az763/MD_STM32F401RCT6/README.md

# Metal detector "YASHKA & MASHKA" on MCU STM32F401RCT6
Metal detector IB on MCU ARM Cortex-M4 STM32F401RCT6. FM Transmitter KT0803L. Default frequency 108.00 MHz (channel 2160). EEPROM AT24C16N. 
Search coil from "Terminator" metal detector. LC circuit "TX" with parallel resonance. Frequency "TX" 19300 Hz (min. 6000 Hz - max. 31000 Hz). LCD display HD44780. 
The electromagnetic imbalance of the IB sensor should be 10-15 millivolts (maximum 20-30 mV when adjusting the input amplifier). 
This is an experimental level project. 

DD8 search coil. Frequency 19 kHz.
The "TX" winding is 38 turns (19+19) and the "RX" winding is 38 turns. Circuit capacitors "TX" and "RX" with a capacity of 100 nf. The diameter of the mandrel is 170 mm and the diameter of the winding wire is 0.4 mm.
The diameter of the search sensor in the form of DD8 is 200 mm.
