az763/MD_STM32F401RCT6/Doc_md/Black Pill STM32F401RCT6.jpg

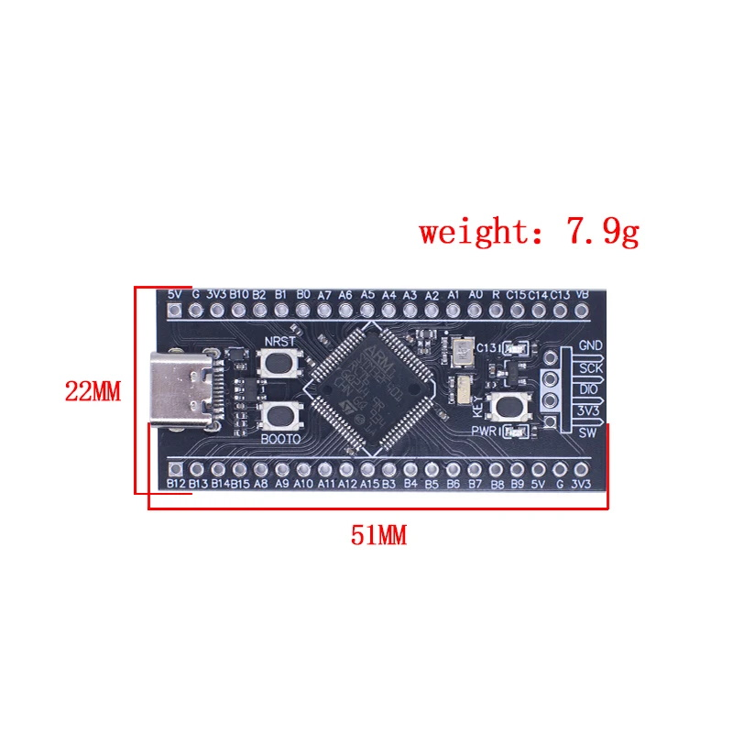
Doc_md/Black Pill STM32F401RCT6.jpg
