az763/MD_STM32F401RCT6/Doc_md/STM32F401 LQFP64 PinOut.jpg

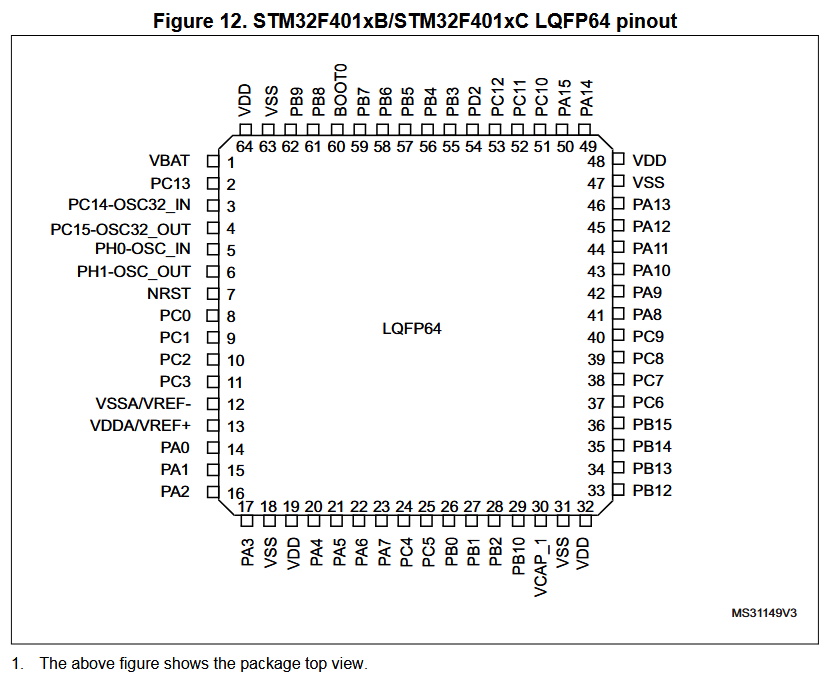
Doc_md/STM32F401 LQFP64 PinOut.jpg
