az763/MD_STM32F401RCT6/PCB/PCB_MD_STM32F401RCT6_1.5_mod_05_OK_foto_00.JPG

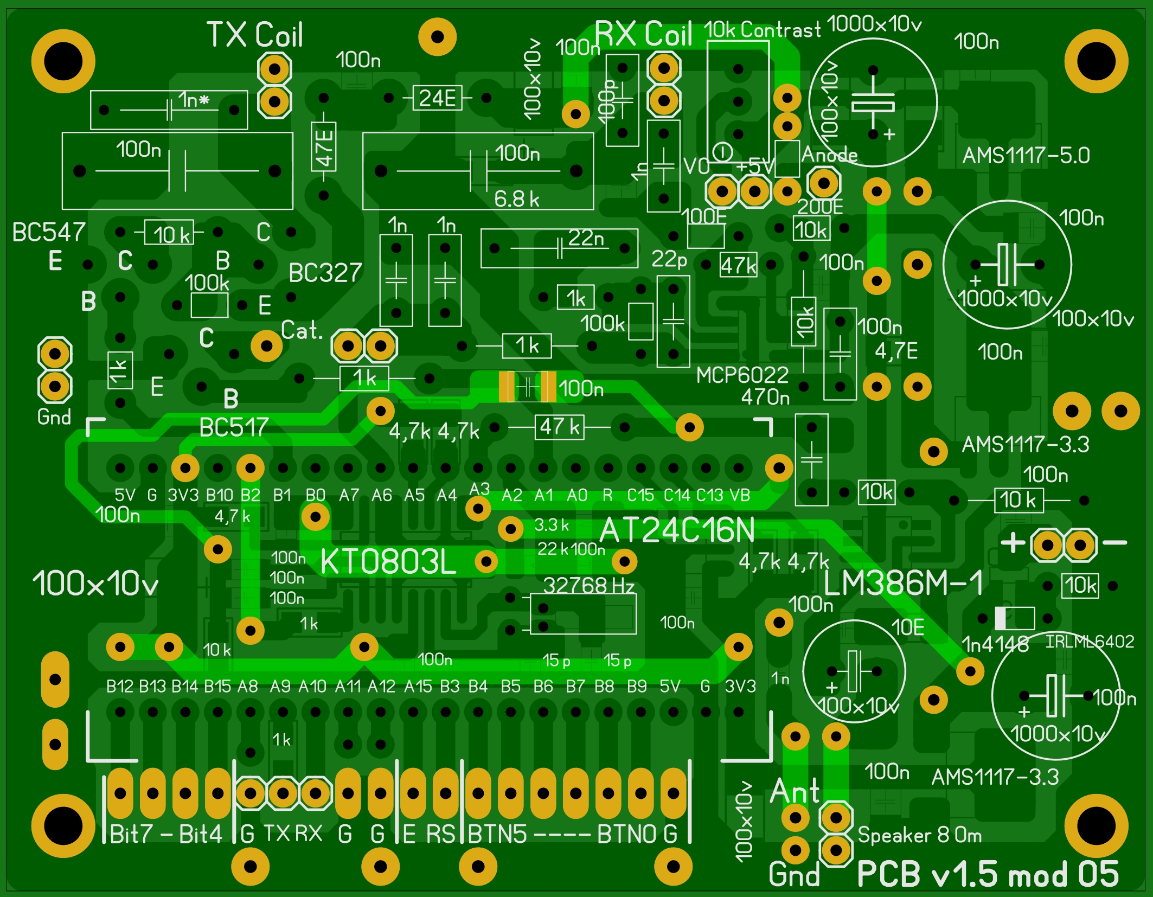
PCB/PCB_MD_STM32F401RCT6_1.5_mod_05_OK_foto_00.JPG
