az763/MD_STM32F401RCT6/Schems_md/Buttons_Sch.png

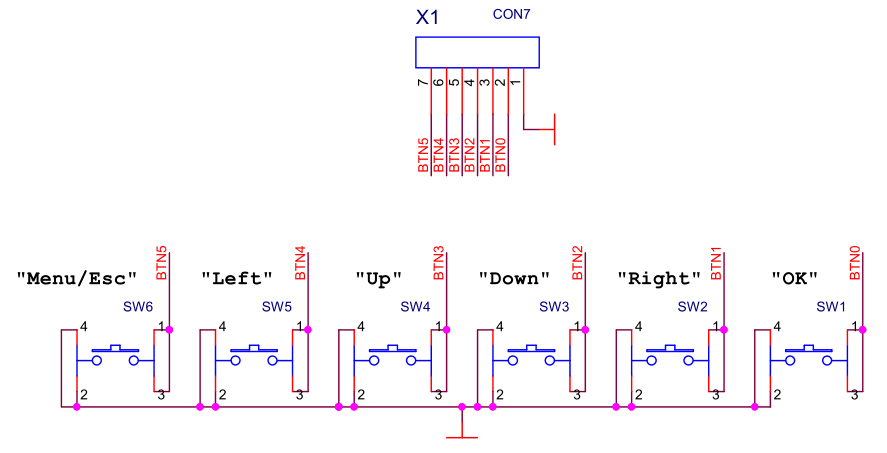
Schems_md/Buttons_Sch.png
