az763/MD_STM32F401RCT6/Schems_md/KT0803L_Schema.jpg

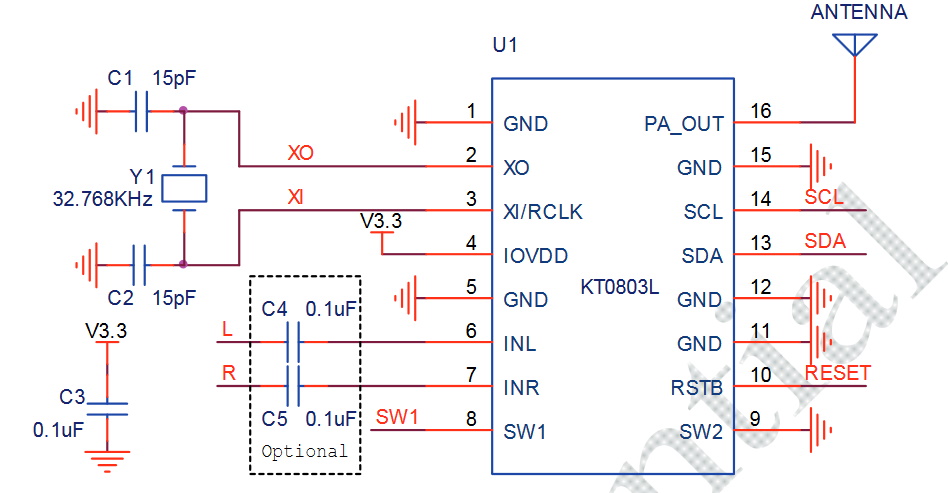
Schems_md/KT0803L_Schema.jpg
