az763/MD_STM32F401RCT6/PCB/PCB_MD_STM32F401RCT6_1.4_step11_foto.JPG

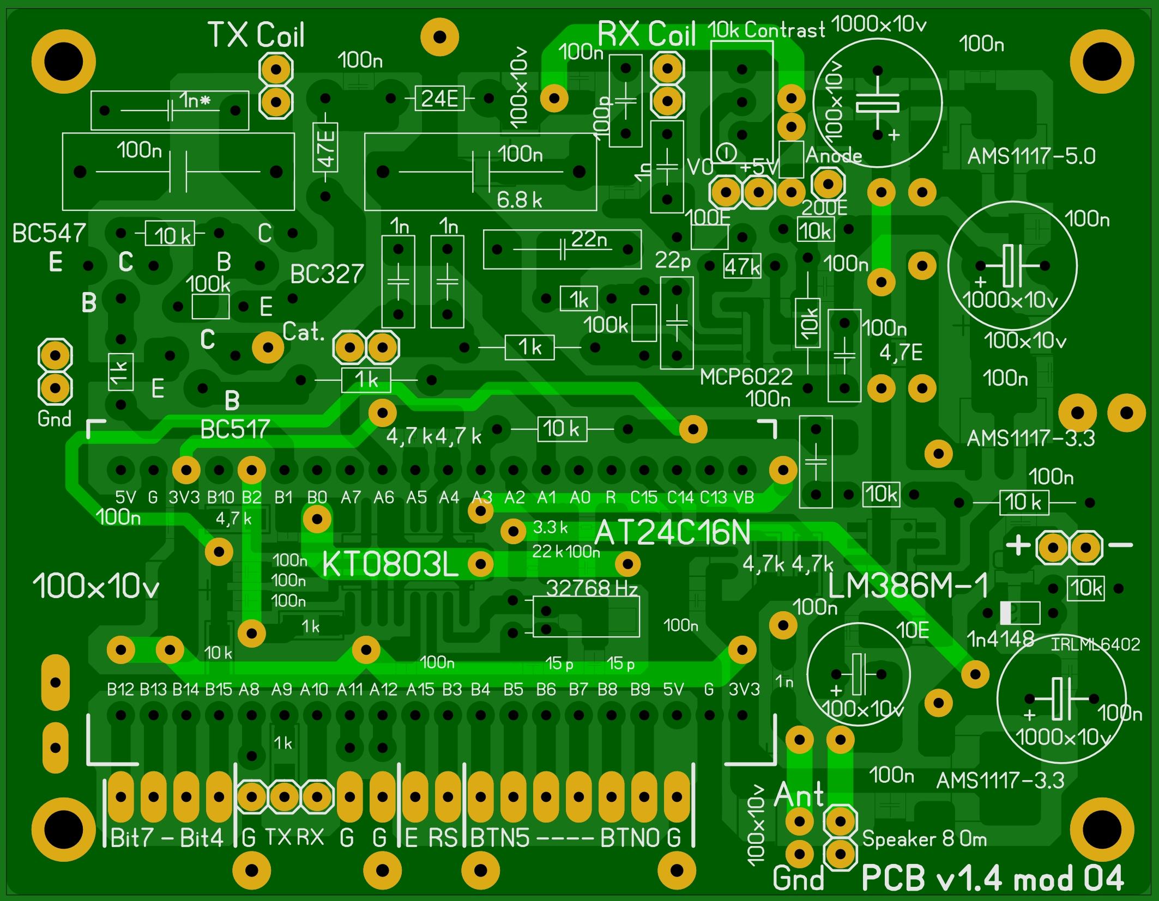
PCB/PCB_MD_STM32F401RCT6_1.4_step11_foto.JPG
