az763/MD_STM32F401RCT6/(list of files, drawings)

Other design files:
PCB/PCB_MD_STM32F401RCT6_1.3.lay6
PCB/PCB_MD_STM32F401RCT6_1.4_mod_04_OK.lay6
PCB/PCB_MD_STM32F401RCT6_1.4_step10_OK.lay6
PCB/PCB_MD_STM32F401RCT6_1.4_step11_OK.lay6
PCB/PCB_MD_STM32F401RCT6_1.5_mod_05_OK.lay6
PCB/PCB_MD_STM32F401RCT6_1.5_step12_OK.lay6
