az763/MD_STM32F401RCT6/MD_STM32F401RCT6.ioc

Mcu.UserName=STM32F401RCTx
PA1.Signal=GPIO_Output
PA10.Signal=USART1_RX
PA15.Signal=GPIO_Output
PA2.Signal=ADCx_IN2
PA3.Signal=S_TIM5_CH4
PA4.Signal=GPIO_Output
PA5.Signal=GPIO_Output
PA6.Signal=ADCx_IN6
PA8.Signal=S_TIM1_CH1
PA9.Signal=USART1_TX
PB1.Signal=S_TIM3_CH4
PB12.Signal=GPIO_Output
PB13.Signal=GPIO_Output
PB14.Signal=GPIO_Output
PB15.Signal=GPIO_Output
PB2.Signal=GPIO_Output
PB3.Signal=GPIO_Output
PB4.Signal=GPIO_Input
PB5.Signal=GPIO_Input
PB6.Signal=GPIO_Input
PB7.Signal=GPIO_Input
PB8.Signal=GPIO_Input
PB9.Signal=GPIO_Input
PC13-ANTI_TAMP.Signal=GPIO_Output
PC14-OSC32_IN.Signal=GPIO_Output
PC15-OSC32_OUT.Signal=GPIO_Output
