az763/MD_STM32F401RCT6/(commit log)

2025-07-27 Create create-folder-pcb
2025-07-27 Create create-folder-Drivers
