az763/MD_STM32F401RCT6/(notices)

Notices in the files:
Core/Inc/flash_protect_f401.h:
Copyright (c) 2023 STMicroelectronics.
All rights reserved.
This software is licensed under terms that can be found in the LICENSE file
Core/Src/main.c:
Copyright (c) 2024 STMicroelectronics.
